tux75at/AtmelHVPP/doc/AtmelHVPP.pdf

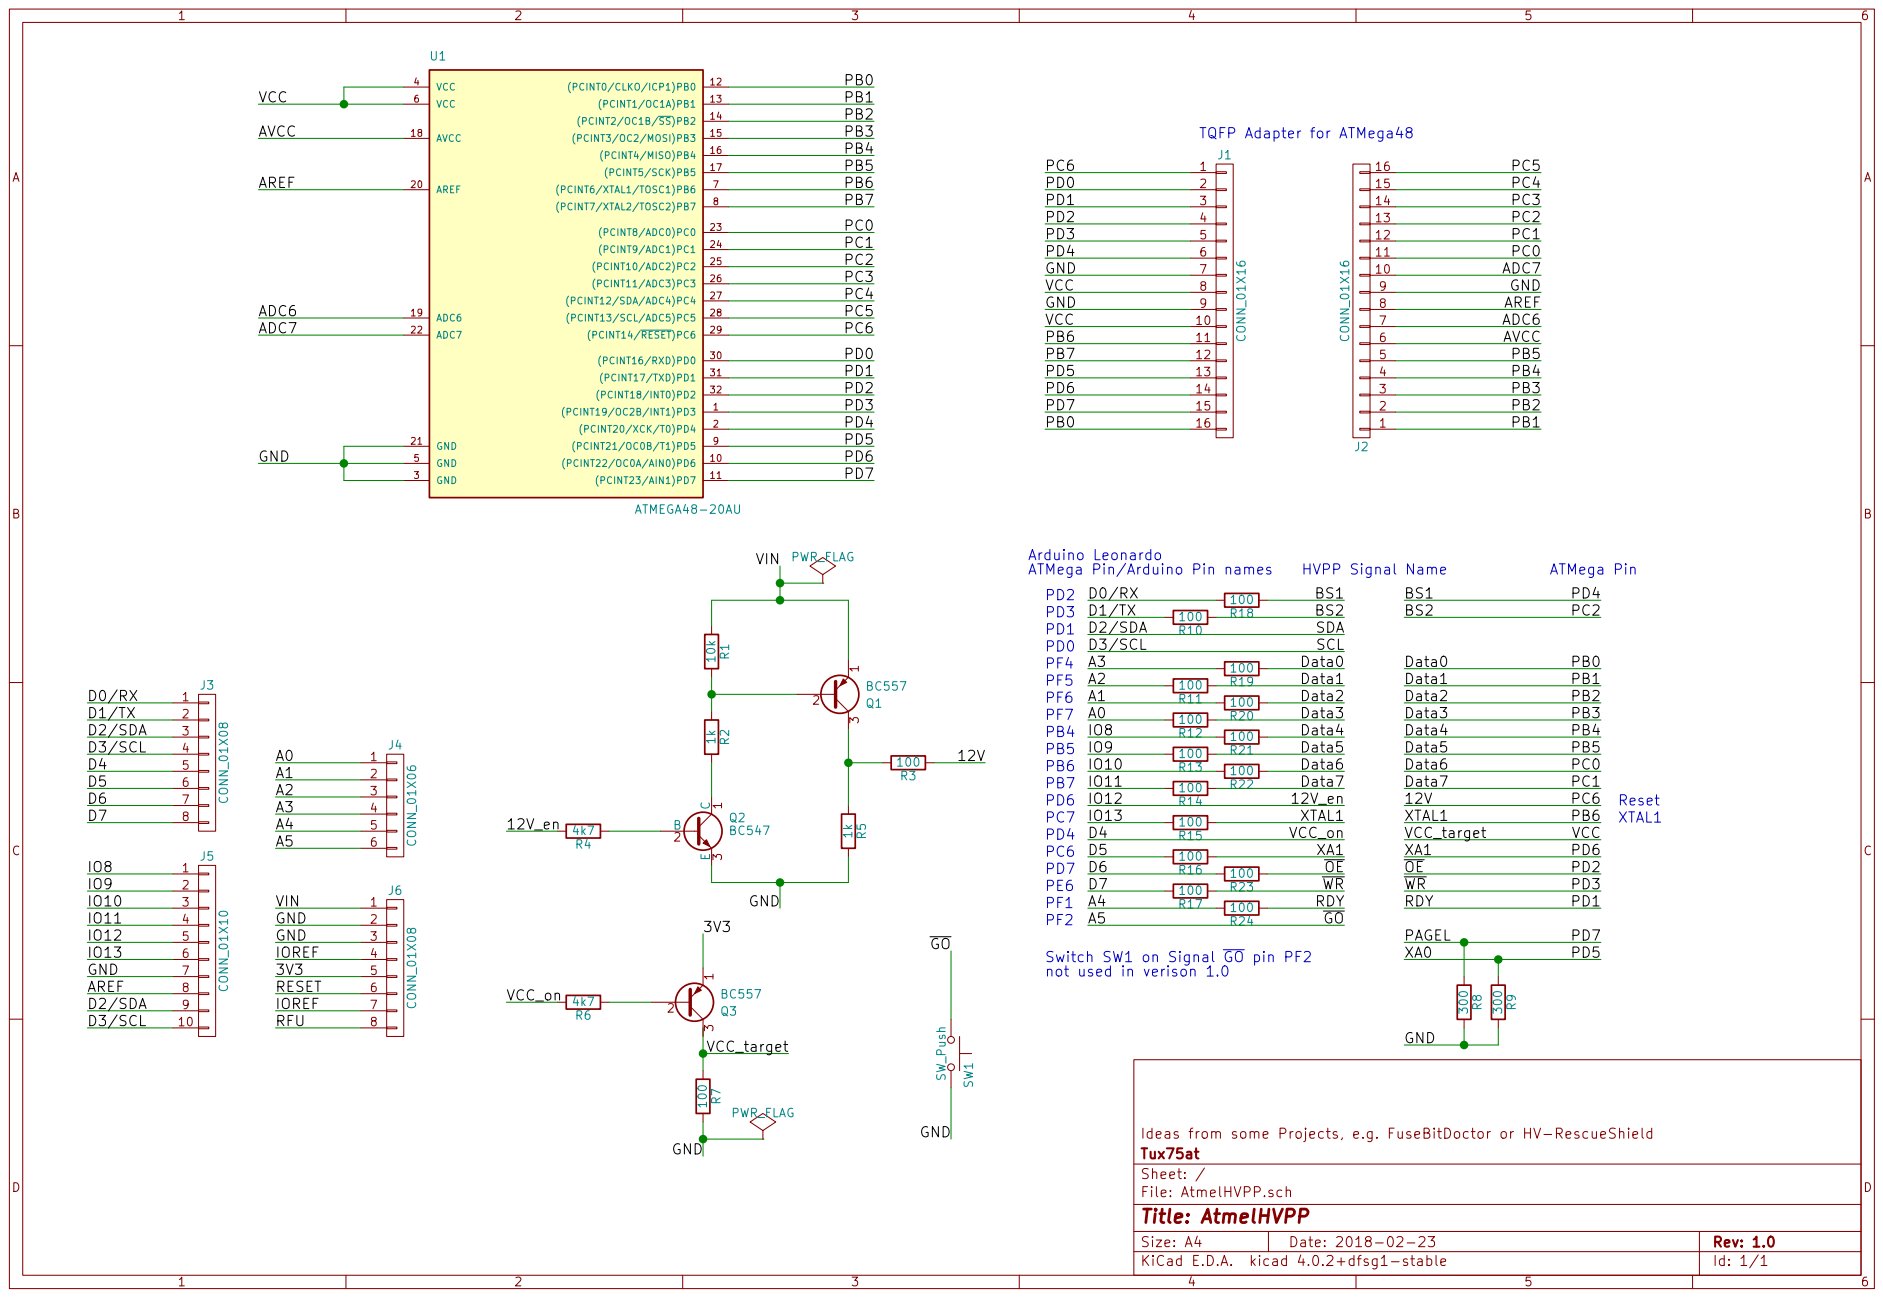
[picture p1: page 1]

Ideas from some Projects, e.g. FuseBitDoctor or HV-RescueShield 123456789

IO9
IO10
IO11 | GND
IO12 | GND

IOREF

File: AtmelHVPP.sch Sheet: / Tux75at
