tux75at/AtmelHVPP/(commit log)

2018-02-24 Initial commit of Schematics
    [AtmelHVPP.kicad_pcb, AtmelHVPP.sch]
2018-02-24 Add resistors into connection to Atmel chip with defect fuses for current limitation
    [AtmelHVPP.sch]
2018-02-24 Initial commit of PDF with schematics
2018-02-24 remove unused buttons library as no buttons are used
2018-02-24 add missing function declaration in twi_display header file
    [twi_display.h]
2018-02-24 fix wron function call to display hex values
    [main.c]
